Ad-Deen/AUV-project-Electrical-stack/Design Files/README.md

All circuits and PCB layouts are designed using EasyEDA Pro.
