Ad-Deen/AUV-project-Electrical-stack/Circuit Diagram/Power Circuit Schematic.jpg

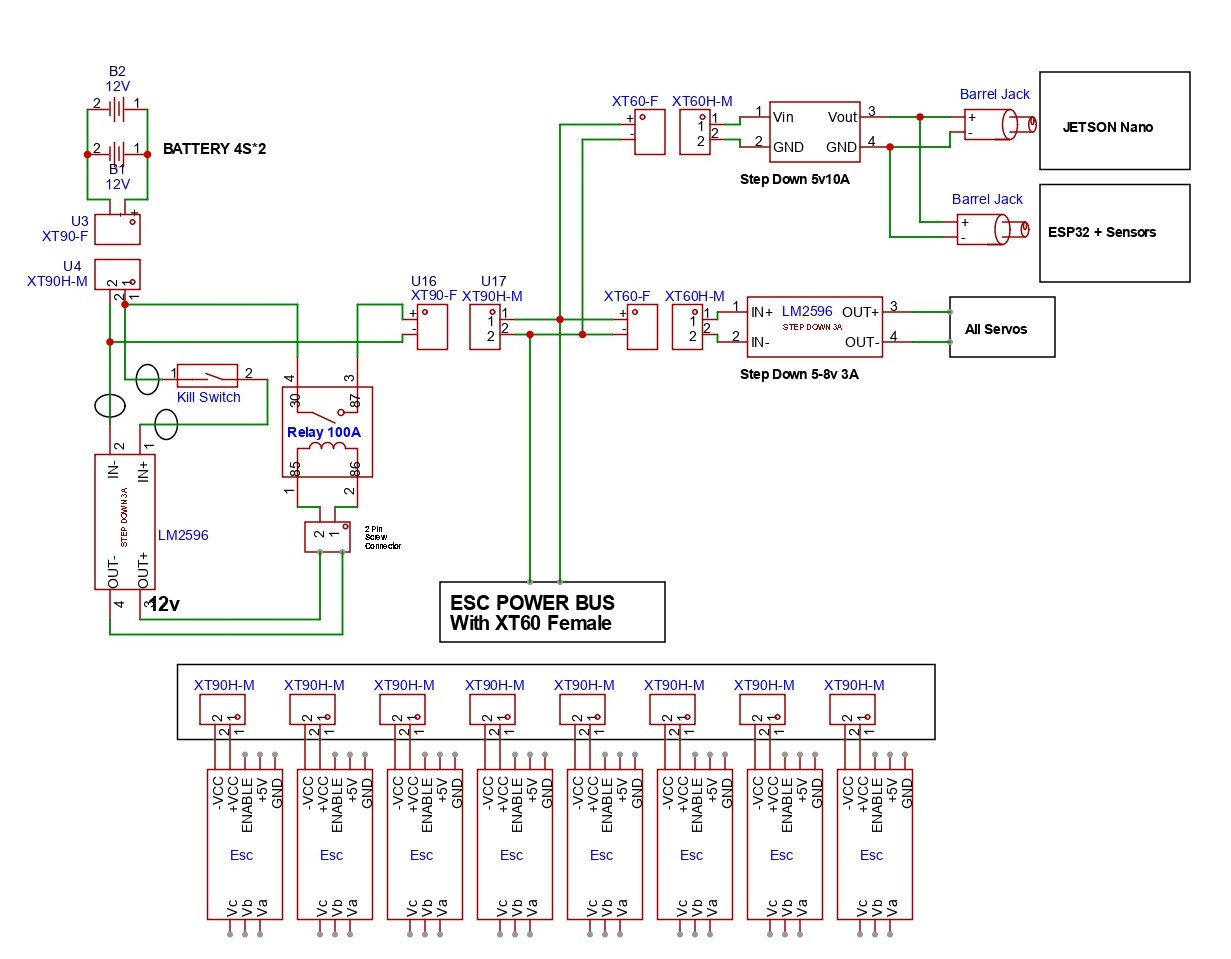
Circuit Diagram/Power Circuit Schematic.jpg
