Ad-Deen/AUV-project-Electrical-stack/Circuit Diagram/ORCA Logic Circuit.pdf

## ESP32 (DEVKITV1) 1 Compass_HMC5883L

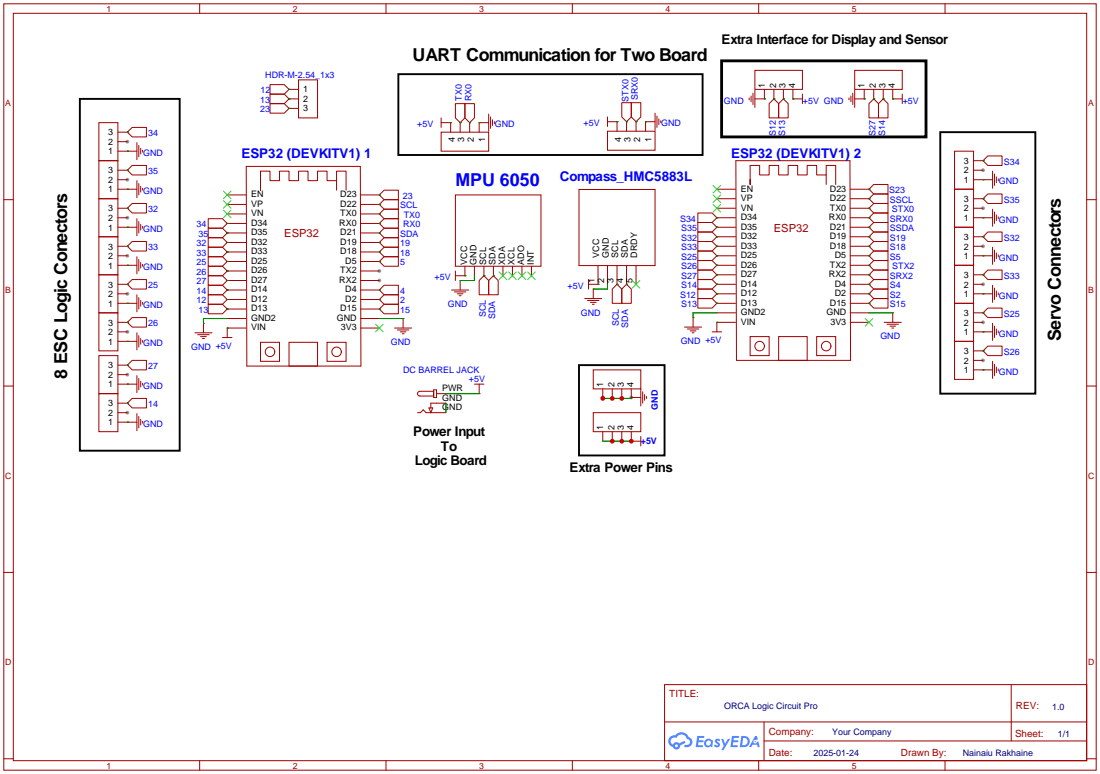
[picture p7: page 1]

UART Communication for Two Board

Extra Interface for Display and Sensor
