Ad-Deen/AUV-project-Electrical-stack/Circuit Diagram/Power Circuit Schematic.pdf

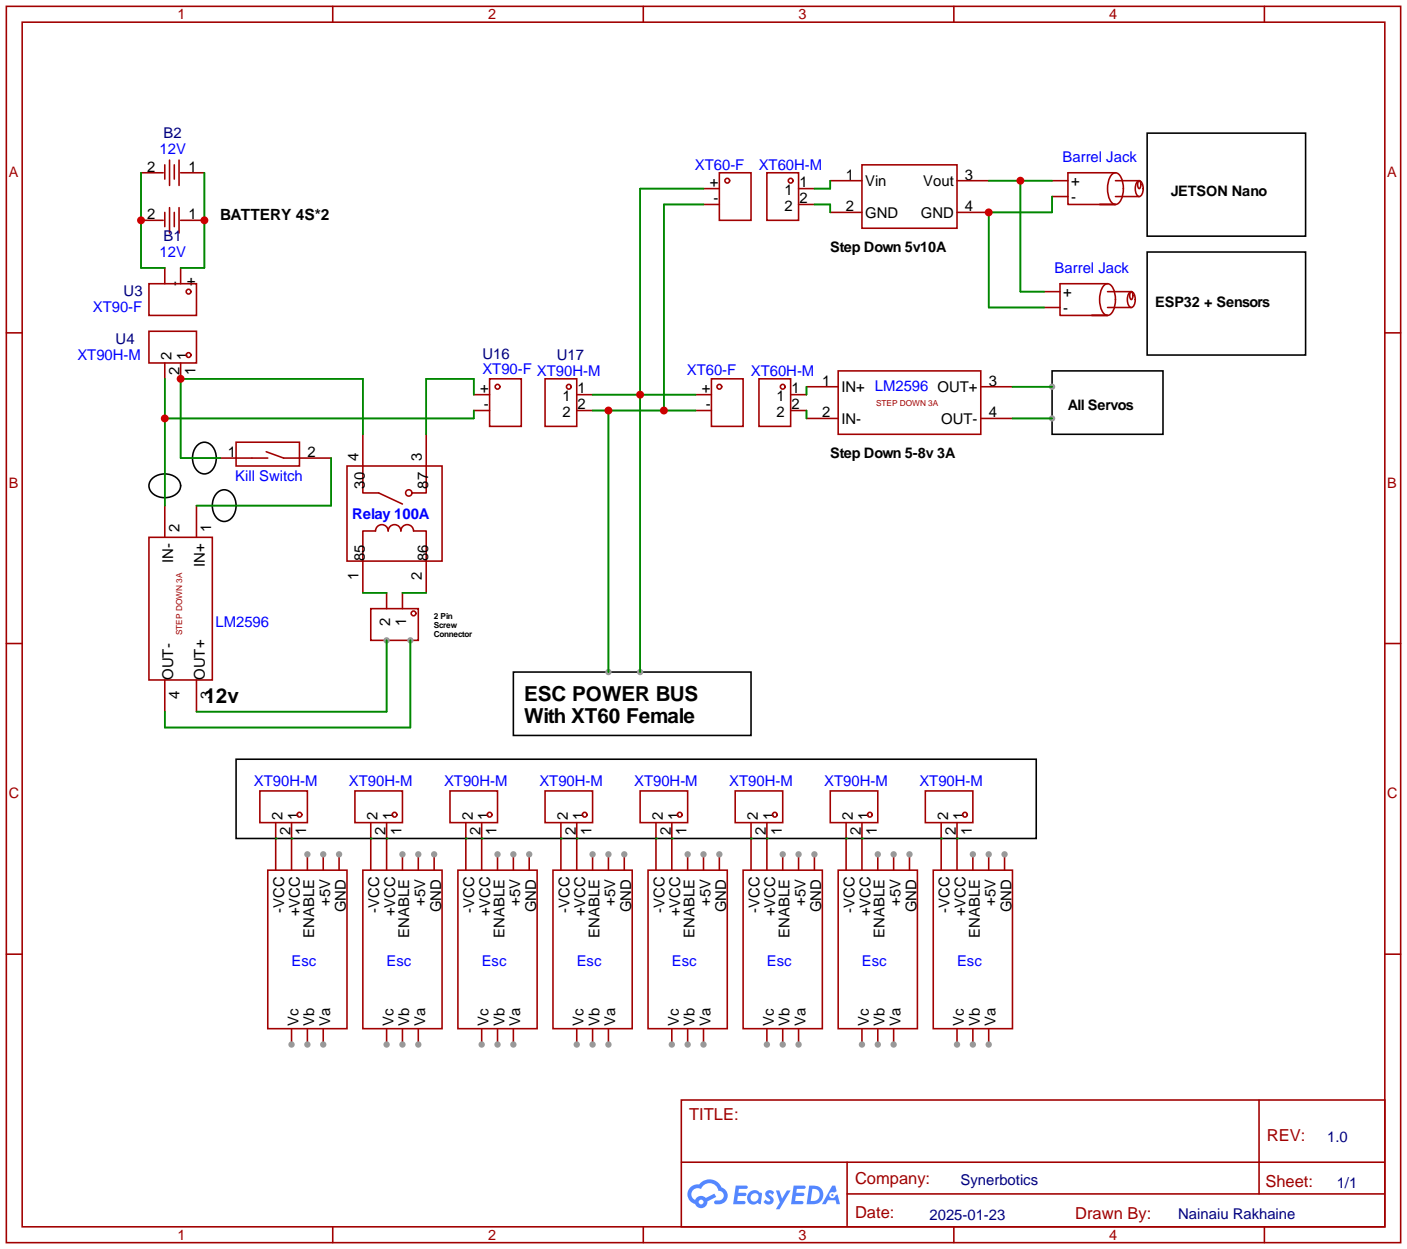
[picture p8: page 1]
