Ad-Deen/AUV-project-Electrical-stack/(list of files, drawings)

Other design files:
Design Files/ORCA Logic Circuit Pro.epro
Design Files/ORCA_Power Bus.epro
